diwou/Dottie_-_The_Matrix_Clock/kicad/source/NTP Dot Matrix Clock 64x16.kicad_pcb

## KiCad design kicad/source/NTP Dot Matrix Clock 64x16.kicad_pcb (2026-06-04)

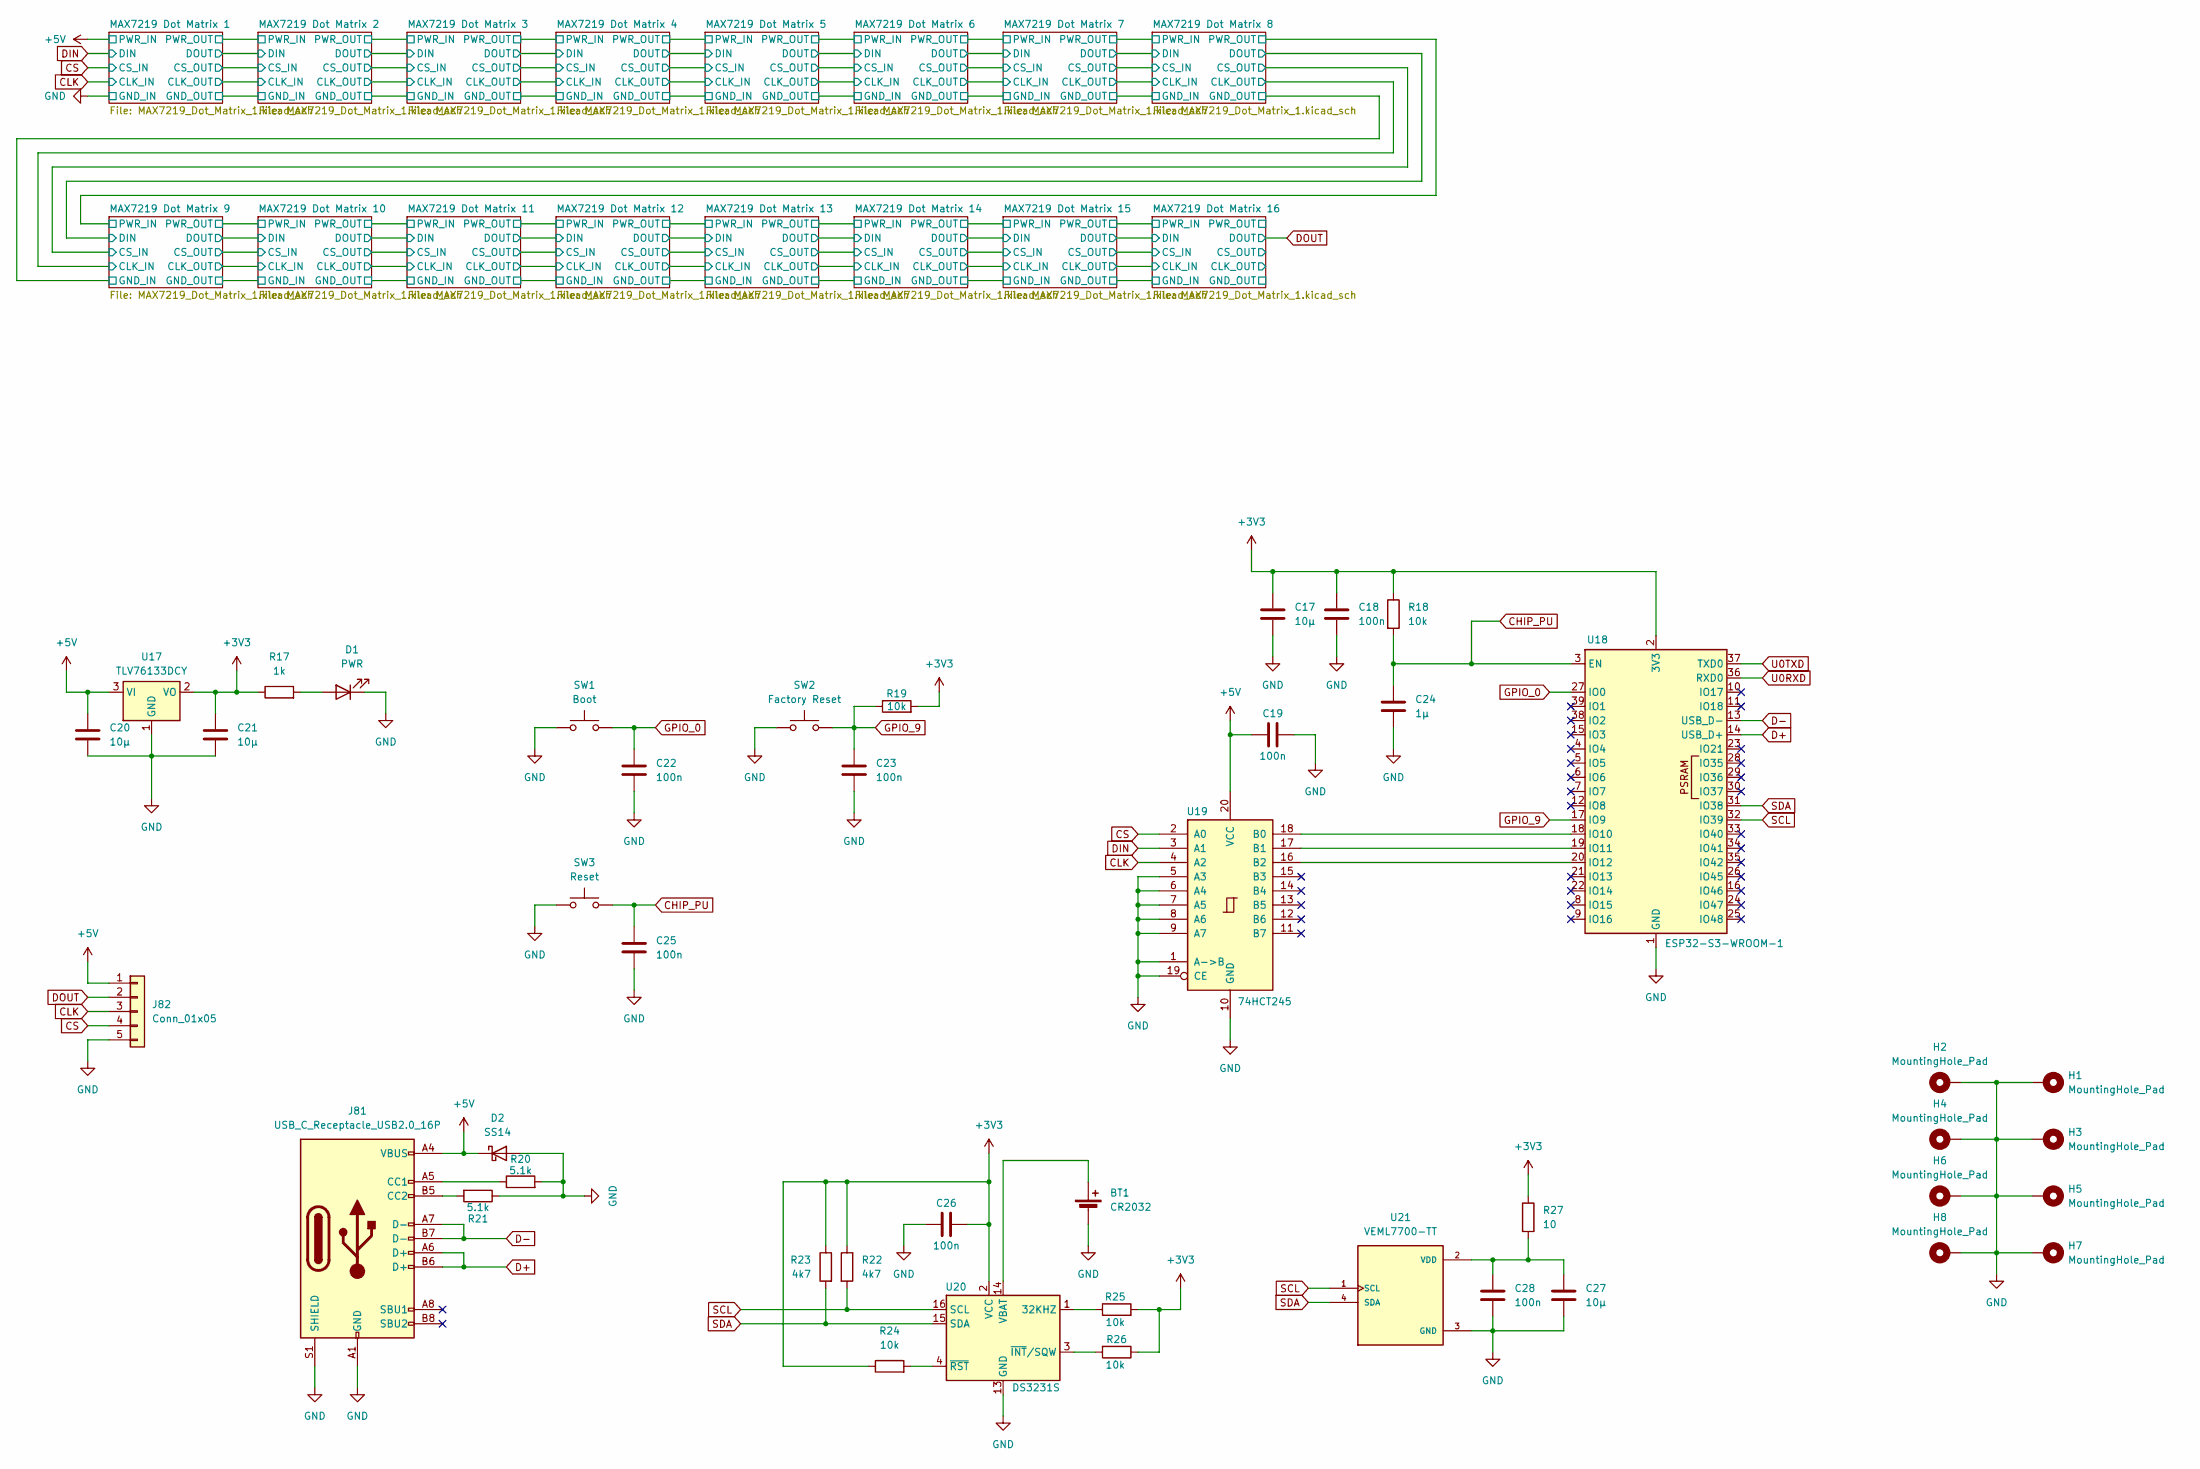
[picture p2: schematic NTP Dot Matrix Clock 64x16.kicad_sch]

Parts:
BT1: CR2032; BatteryHolder_MYOUNG_BS-07-A1BJ001_CR2032
C17, C27: 10µ; C_0805_2012Metric_Pad1.18x1.45mm_HandSolder
C18, C19, C22, C23, C25, C26, C28: 100n; C_0805_2012Metric_Pad1.18x1.45mm_HandSolder
C20, C21: 10µ; C_1206_3216Metric_Pad1.33x1.80mm_HandSolder
C24: 1µ; C_0805_2012Metric_Pad1.18x1.45mm_HandSolder
D1: PWR; LED_0805_2012Metric_Pad1.15x1.40mm_HandSolder
D2: SS14; D_SMA
H1, H2, H3, H4, H5, H6, H7, H8: MountingHole_Pad; MountingHole_3.2mm_M3_DIN965_Pad
J81: USB_C_Receptacle_USB2.0_16P; USB_C_Receptacle_HCTL_HC-TYPE-C-16P-01A
J82: Conn_01x05; PinHeader_1x05_P2.54mm_Vertical
R17: 1k; R_0805_2012Metric_Pad1.20x1.40mm_HandSolder
R18, R19, R24, R25, R26: 10k; R_0805_2012Metric_Pad1.20x1.40mm_HandSolder
R20, R21: 5.1k; R_0805_2012Metric_Pad1.20x1.40mm_HandSolder
R22, R23: 4k7; R_0805_2012Metric_Pad1.20x1.40mm_HandSolder
R27: 10; R_0805_2012Metric_Pad1.20x1.40mm_HandSolder
SW1: Boot; SW_PUSH_6mm_H5mm
SW2: Factory Reset; SW_PUSH_6mm_H5mm
SW3: Reset; SW_PUSH_6mm_H5mm
U17: TLV76133DCY; SOT-223-3_TabPin2
U18: ESP32-S3-WROOM-1
U19: 74HCT245; TSSOP-20_4.4x6.5mm_P0.65mm
U20: DS3231S; SOIC-16W_7.5x10.3mm_P1.27mm
U21: VEML7700-TT; XDCR_VEML7700-TT; PARTREV 1.6

Connections:
+3V3: C17.1, C18.1, C21.1, C26.2, R17.1, R18.1, R19.2, R22.1, R23.1, R24.1, R25.2, R26.1, R27.1, U17.2 (VO), U18.2 (3V3), U20.2 (VCC)
+5V: C19.1, C20.1, D2.1 (K), J81.A4 (VBUS), J81.A9 (VBUS), J81.B4 (VBUS), J81.B9 (VBUS), J82.1, U17.3 (VI), U19.20 (VCC); also elsewhere on the board
CHIP_PU: C24.1, C25.1, R18.2, SW3.2, U18.3 (EN)
CLK: J82.3, U19.4 (A2); also elsewhere on the board
CS: J82.4, U19.2 (A0); also elsewhere on the board
D+: J81.A6 (D+), J81.B6 (D+), U18.14 (USB_D+)
D-: J81.A7 (D-), J81.B7 (D-), U18.13 (USB_D-)
DIN: U19.3 (A1); also elsewhere on the board
DOUT: J82.2; also elsewhere on the board
GND: BT1.2 (-), C17.2, C18.2, C19.2, C20.2, C21.2, C22.2, C23.2, C24.2, C25.2, C26.1, C27.2, C28.2, D1.1 (K), D2.2 (A), H1.1 (1_1), H2.1 (1_1), H3.1 (1_1), H4.1 (1_1), H5.1 (1_1), H6.1 (1_1), H7.1 (1_1), H8.1 (1_1), J81.A1 (GND), J81.A12 (GND), J81.B1 (GND), J81.B12 (GND), J81.S1 (SHIELD), J82.5, R20.2, R21.1, SW1.1, SW2.1, SW3.1, U17.1 (GND), U18.1 (GND), U18.40 (GND), U18.41 (GND), U19.1 (A->B), U19.5 (A3), U19.6 (A4), U19.7 (A5), U19.8 (A6), U19.9 (A7), U19.10 (GND), U19.19 (CE), U20.5 (GND), U20.6 (GND), U20.7 (GND), U20.8 (GND), U20.9 (GND), U20.10 (GND), U20.11 (GND), U20.12 (GND), U20.13 (GND), U21.3 (GND); also elsewhere on the board
GPIO_0: C22.1, SW1.2, U18.27 (IO0)
GPIO_9: C23.1, R19.1, SW2.2, U18.17 (IO9)
unnamed: BT1.1 (+), U20.14 (VBAT)
unnamed: D1.2 (A), R17.2
unnamed: J81.A5 (CC1), R20.1
unnamed: J81.B5 (CC2), R21.2
unnamed: U18.18 (IO10), U19.18 (B0)
unnamed: U18.19 (IO11), U19.17 (B1)
unnamed: U18.20 (IO12), U19.16 (B2)
unnamed: R25.1, U20.1 (32KHZ)
unnamed: R26.2, U20.3 (~INT/SQW)
unnamed: R24.2, U20.4 (~RST)
unnamed: C27.1, C28.1, R27.2, U21.2 (VDD)
SCL: R22.2, U18.32 (IO39), U20.16 (SCL), U21.1 (SCL)
SDA: R23.2, U18.31 (IO38), U20.15 (SDA), U21.4 (SDA)
U0RXD: U18.36 (RXD0)
U0TXD: U18.37 (TXD0)

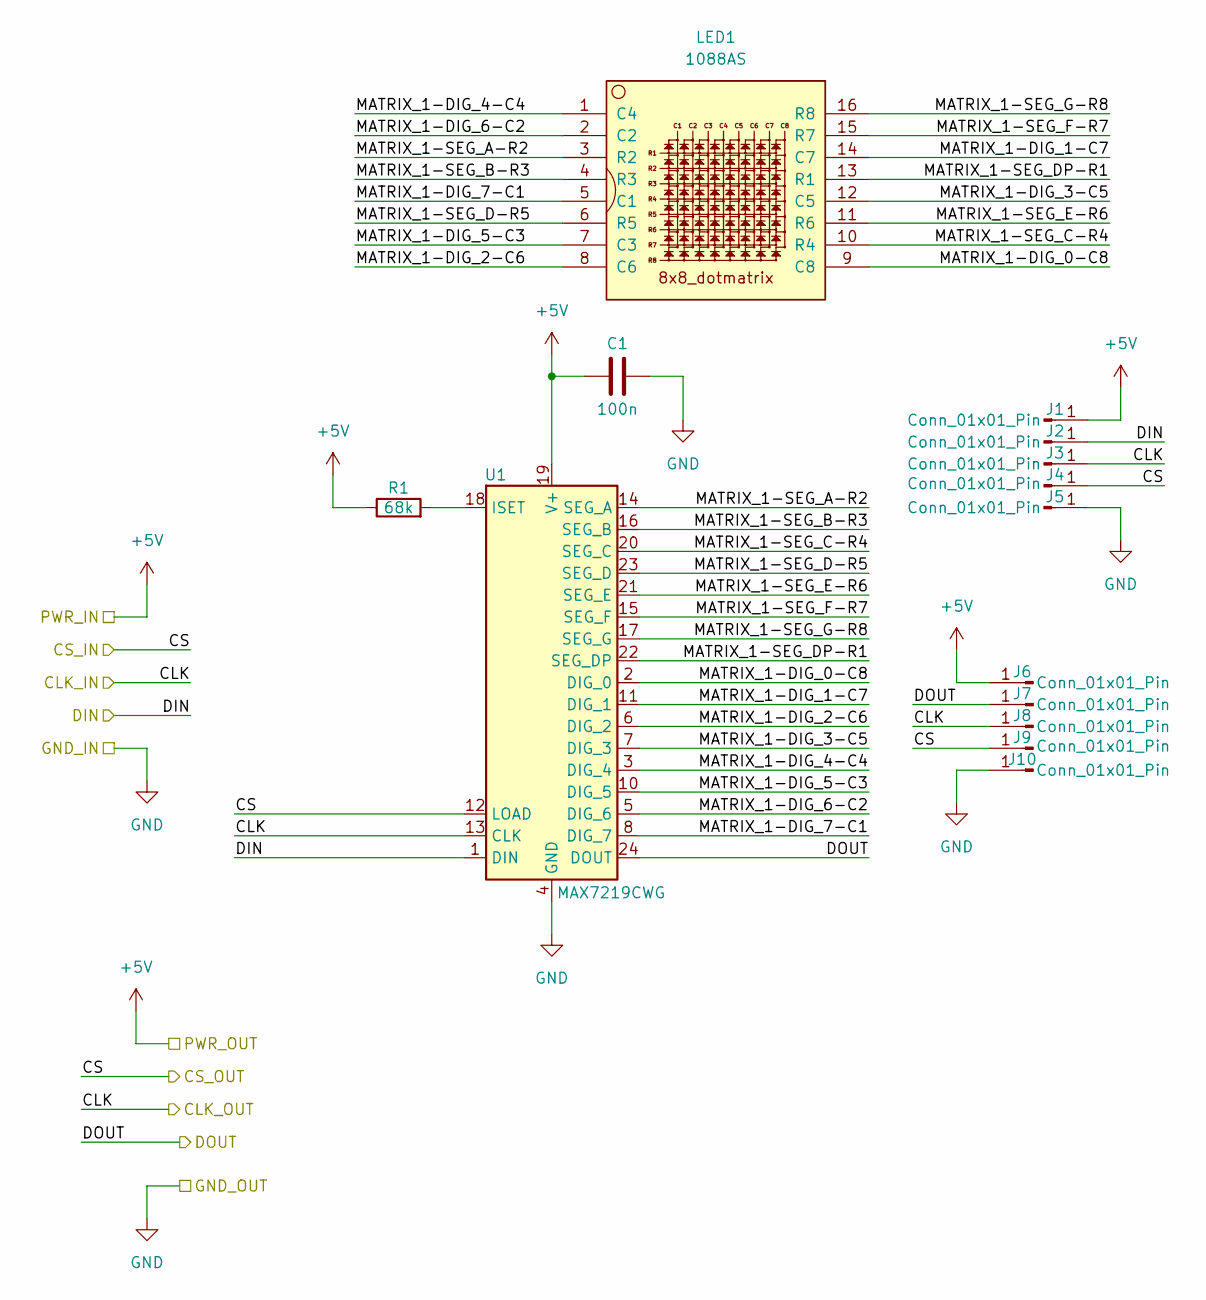
[picture p3: schematic MAX7219_Dot_Matrix_1.kicad_sch, NTP Dot Matrix Clock 64x16]

Parts:
C1: 100n; C_0805_2012Metric_Pad1.18x1.45mm_HandSolder
J1, J2, J3, J4, J5, J6, J7, J8, J9, J10: Conn_01x01_Pin; TestPoint_Pad_1.5x1.5mm
LED1: 1088AS; LED_1088_Pin_Header
R1: 68k; R_0805_2012Metric_Pad1.20x1.40mm_HandSolder
U1: MAX7219CWG; SOIC-24W_7.5x15.4mm_P1.27mm

Connections:
+5V: C1.1, J1.1 (Pin_1_1), J6.1 (Pin_1_1), R1.1, U1.19 (V+); also elsewhere on the board
/MAX7219 Dot Matrix 1/DOUT: J7.1 (Pin_1_1), U1.24 (DOUT); also elsewhere on the board
/MAX7219 Dot Matrix 1/MATRIX_1-DIG_0-C8: LED1.9 (C8), U1.2 (DIG_0)
/MAX7219 Dot Matrix 1/MATRIX_1-DIG_1-C7: LED1.14 (C7), U1.11 (DIG_1)
/MAX7219 Dot Matrix 1/MATRIX_1-DIG_2-C6: LED1.8 (C6), U1.6 (DIG_2)
/MAX7219 Dot Matrix 1/MATRIX_1-DIG_3-C5: LED1.12 (C5), U1.7 (DIG_3)
/MAX7219 Dot Matrix 1/MATRIX_1-DIG_4-C4: LED1.1 (C4), U1.3 (DIG_4)
/MAX7219 Dot Matrix 1/MATRIX_1-DIG_5-C3: LED1.7 (C3), U1.10 (DIG_5)
/MAX7219 Dot Matrix 1/MATRIX_1-DIG_6-C2: LED1.2 (C2), U1.5 (DIG_6)
/MAX7219 Dot Matrix 1/MATRIX_1-DIG_7-C1: LED1.5 (C1), U1.8 (DIG_7)
/MAX7219 Dot Matrix 1/MATRIX_1-SEG_A-R2: LED1.3 (R2), U1.14 (SEG_A)
/MAX7219 Dot Matrix 1/MATRIX_1-SEG_B-R3: LED1.4 (R3), U1.16 (SEG_B)
/MAX7219 Dot Matrix 1/MATRIX_1-SEG_C-R4: LED1.10 (R4), U1.20 (SEG_C)
/MAX7219 Dot Matrix 1/MATRIX_1-SEG_D-R5: LED1.6 (R5), U1.23 (SEG_D)
/MAX7219 Dot Matrix 1/MATRIX_1-SEG_DP-R1: LED1.13 (R1), U1.22 (SEG_DP)
/MAX7219 Dot Matrix 1/MATRIX_1-SEG_E-R6: LED1.11 (R6), U1.21 (SEG_E)
/MAX7219 Dot Matrix 1/MATRIX_1-SEG_F-R7: LED1.15 (R7), U1.15 (SEG_F)
/MAX7219 Dot Matrix 1/MATRIX_1-SEG_G-R8: LED1.16 (R8), U1.17 (SEG_G)
CLK: J3.1 (Pin_1_1), J8.1 (Pin_1_1), U1.13 (CLK); also elsewhere on the board
CS: J4.1 (Pin_1_1), J9.1 (Pin_1_1), U1.12 (LOAD); also elsewhere on the board
DIN: J2.1 (Pin_1_1), U1.1 (DIN); also elsewhere on the board
GND: C1.2, J5.1 (Pin_1_1), J10.1 (Pin_1_1), U1.4 (GND), U1.9 (GND); also elsewhere on the board
unnamed: R1.2, U1.18 (ISET)

Parts of its further copies:
C2, C3, C4, C5, C6, C7, C8, C9, C10, C11, C12, C13, C14, C15, C16: 100n; C_0805_2012Metric_Pad1.18x1.45mm_HandSolder
J11, J12, J13, J14, J15, J16, J17, J18, J19, J20, J21, J22, J23, J24, J25, J26, J27, J28, J29, J30, J31, J32, J33, J34, J35, J36, J37, J38, J39, J40, J41, J42, J43, J44, J45, J46, J47, J48, J49, J50, J51, J52, J53, J54, J55, J56, J57, J58, J59, J60, J61, J62, J63, J64, J65, J66, J67, J68, J69, J70, J71, J72, J73, J74, J75, J76, J77, J78, J79, J80, J83, J84, J85, J86, J87, J88, J89, J90, J91, J92, J93, J94, J95, J96, J97, J98, J99, J100, J101, J102, J103, J104, J105, J106, J107, J108, J109, J110, J111, J112, J113, J114, J115, J116, J117, J118, J119, J120, J121, J122, J123, J124, J125, J126, J127, J128, J129, J130, J131, J132, J133, J134, J135, J136, J137, J138, J139, J140, J141, J142, J143, J144, J145, J146, J147, J148, J149, J150, J151, J152, J153, J154, J155, J156, J157, J158, J159, J160, J161, J162: Conn_01x01_Pin; TestPoint_Pad_1.5x1.5mm
LED2, LED3, LED4, LED5, LED6, LED7, LED8, LED9, LED10, LED11, LED12, LED13, LED14, LED15, LED16: 1088AS; LED_1088_Pin_Header
R2, R3, R4, R5, R6, R7, R8, R9, R10, R11, R12, R13, R14, R15, R16: 68k; R_0805_2012Metric_Pad1.20x1.40mm_HandSolder
U2, U3, U4, U5, U6, U7, U8, U9, U10, U11, U12, U13, U14, U15, U16: MAX7219CWG; SOIC-24W_7.5x15.4mm_P1.27mm

Connections of its further copies:
+5V: C2.1, C3.1, C4.1, C5.1, C6.1, C7.1, C8.1, C9.1, C10.1, C11.1, C12.1, C13.1, C14.1, C15.1, C16.1, J11.1 (Pin_1_1), J16.1 (Pin_1_1), J21.1 (Pin_1_1), J26.1 (Pin_1_1), J31.1 (Pin_1_1), J36.1 (Pin_1_1), J41.1 (Pin_1_1), J46.1 (Pin_1_1), J51.1 (Pin_1_1), J56.1 (Pin_1_1), J61.1 (Pin_1_1), J66.1 (Pin_1_1), J71.1 (Pin_1_1), J76.1 (Pin_1_1), J83.1 (Pin_1_1), J88.1 (Pin_1_1), J93.1 (Pin_1_1), J98.1 (Pin_1_1), J103.1 (Pin_1_1), J108.1 (Pin_1_1), J113.1 (Pin_1_1), J118.1 (Pin_1_1), J123.1 (Pin_1_1), J128.1 (Pin_1_1), J133.1 (Pin_1_1), J138.1 (Pin_1_1), J143.1 (Pin_1_1), J148.1 (Pin_1_1), J153.1 (Pin_1_1), J158.1 (Pin_1_1), R2.1, R3.1, R4.1, R5.1, R6.1, R7.1, R8.1, R9.1, R10.1, R11.1, R12.1, R13.1, R14.1, R15.1, R16.1, U2.19 (V+), U3.19 (V+), U4.19 (V+), U5.19 (V+), U6.19 (V+), U7.19 (V+), U8.19 (V+), U9.19 (V+), U10.19 (V+), U11.19 (V+), U12.19 (V+), U13.19 (V+), U14.19 (V+), U15.19 (V+), U16.19 (V+); also elsewhere on the board
/MAX7219 Dot Matrix 1/DOUT: J12.1 (Pin_1_1), U2.1 (DIN); also elsewhere on the board
/MAX7219 Dot Matrix 2/DOUT: J17.1 (Pin_1_1), J22.1 (Pin_1_1), U2.24 (DOUT), U3.1 (DIN)
/MAX7219 Dot Matrix 2/MATRIX_1-DIG_0-C8: LED2.9 (C8), U2.2 (DIG_0)
/MAX7219 Dot Matrix 2/MATRIX_1-DIG_1-C7: LED2.14 (C7), U2.11 (DIG_1)
/MAX7219 Dot Matrix 2/MATRIX_1-DIG_2-C6: LED2.8 (C6), U2.6 (DIG_2)
/MAX7219 Dot Matrix 2/MATRIX_1-DIG_3-C5: LED2.12 (C5), U2.7 (DIG_3)
/MAX7219 Dot Matrix 2/MATRIX_1-DIG_4-C4: LED2.1 (C4), U2.3 (DIG_4)
/MAX7219 Dot Matrix 2/MATRIX_1-DIG_5-C3: LED2.7 (C3), U2.10 (DIG_5)
/MAX7219 Dot Matrix 2/MATRIX_1-DIG_6-C2: LED2.2 (C2), U2.5 (DIG_6)
/MAX7219 Dot Matrix 2/MATRIX_1-DIG_7-C1: LED2.5 (C1), U2.8 (DIG_7)
/MAX7219 Dot Matrix 2/MATRIX_1-SEG_A-R2: LED2.3 (R2), U2.14 (SEG_A)
/MAX7219 Dot Matrix 2/MATRIX_1-SEG_B-R3: LED2.4 (R3), U2.16 (SEG_B)
/MAX7219 Dot Matrix 2/MATRIX_1-SEG_C-R4: LED2.10 (R4), U2.20 (SEG_C)
/MAX7219 Dot Matrix 2/MATRIX_1-SEG_D-R5: LED2.6 (R5), U2.23 (SEG_D)
/MAX7219 Dot Matrix 2/MATRIX_1-SEG_DP-R1: LED2.13 (R1), U2.22 (SEG_DP)
/MAX7219 Dot Matrix 2/MATRIX_1-SEG_E-R6: LED2.11 (R6), U2.21 (SEG_E)
/MAX7219 Dot Matrix 2/MATRIX_1-SEG_F-R7: LED2.15 (R7), U2.15 (SEG_F)
/MAX7219 Dot Matrix 2/MATRIX_1-SEG_G-R8: LED2.16 (R8), U2.17 (SEG_G)
/MAX7219 Dot Matrix 3/DOUT: J27.1 (Pin_1_1), J32.1 (Pin_1_1), U3.24 (DOUT), U4.1 (DIN)
/MAX7219 Dot Matrix 3/MATRIX_1-DIG_0-C8: LED3.9 (C8), U3.2 (DIG_0)
/MAX7219 Dot Matrix 3/MATRIX_1-DIG_1-C7: LED3.14 (C7), U3.11 (DIG_1)
/MAX7219 Dot Matrix 3/MATRIX_1-DIG_2-C6: LED3.8 (C6), U3.6 (DIG_2)
/MAX7219 Dot Matrix 3/MATRIX_1-DIG_3-C5: LED3.12 (C5), U3.7 (DIG_3)
/MAX7219 Dot Matrix 3/MATRIX_1-DIG_4-C4: LED3.1 (C4), U3.3 (DIG_4)
/MAX7219 Dot Matrix 3/MATRIX_1-DIG_5-C3: LED3.7 (C3), U3.10 (DIG_5)
/MAX7219 Dot Matrix 3/MATRIX_1-DIG_6-C2: LED3.2 (C2), U3.5 (DIG_6)
/MAX7219 Dot Matrix 3/MATRIX_1-DIG_7-C1: LED3.5 (C1), U3.8 (DIG_7)
/MAX7219 Dot Matrix 3/MATRIX_1-SEG_A-R2: LED3.3 (R2), U3.14 (SEG_A)
/MAX7219 Dot Matrix 3/MATRIX_1-SEG_B-R3: LED3.4 (R3), U3.16 (SEG_B)
/MAX7219 Dot Matrix 3/MATRIX_1-SEG_C-R4: LED3.10 (R4), U3.20 (SEG_C)
/MAX7219 Dot Matrix 3/MATRIX_1-SEG_D-R5: LED3.6 (R5), U3.23 (SEG_D)
/MAX7219 Dot Matrix 3/MATRIX_1-SEG_DP-R1: LED3.13 (R1), U3.22 (SEG_DP)
/MAX7219 Dot Matrix 3/MATRIX_1-SEG_E-R6: LED3.11 (R6), U3.21 (SEG_E)
/MAX7219 Dot Matrix 3/MATRIX_1-SEG_F-R7: LED3.15 (R7), U3.15 (SEG_F)
/MAX7219 Dot Matrix 3/MATRIX_1-SEG_G-R8: LED3.16 (R8), U3.17 (SEG_G)
/MAX7219 Dot Matrix 4/DOUT: J37.1 (Pin_1_1), J42.1 (Pin_1_1), U4.24 (DOUT), U5.1 (DIN)
/MAX7219 Dot Matrix 4/MATRIX_1-DIG_0-C8: LED4.9 (C8), U4.2 (DIG_0)
/MAX7219 Dot Matrix 4/MATRIX_1-DIG_1-C7: LED4.14 (C7), U4.11 (DIG_1)
/MAX7219 Dot Matrix 4/MATRIX_1-DIG_2-C6: LED4.8 (C6), U4.6 (DIG_2)
/MAX7219 Dot Matrix 4/MATRIX_1-DIG_3-C5: LED4.12 (C5), U4.7 (DIG_3)
/MAX7219 Dot Matrix 4/MATRIX_1-DIG_4-C4: LED4.1 (C4), U4.3 (DIG_4)
/MAX7219 Dot Matrix 4/MATRIX_1-DIG_5-C3: LED4.7 (C3), U4.10 (DIG_5)
/MAX7219 Dot Matrix 4/MATRIX_1-DIG_6-C2: LED4.2 (C2), U4.5 (DIG_6)
/MAX7219 Dot Matrix 4/MATRIX_1-DIG_7-C1: LED4.5 (C1), U4.8 (DIG_7)
/MAX7219 Dot Matrix 4/MATRIX_1-SEG_A-R2: LED4.3 (R2), U4.14 (SEG_A)
/MAX7219 Dot Matrix 4/MATRIX_1-SEG_B-R3: LED4.4 (R3), U4.16 (SEG_B)
/MAX7219 Dot Matrix 4/MATRIX_1-SEG_C-R4: LED4.10 (R4), U4.20 (SEG_C)
/MAX7219 Dot Matrix 4/MATRIX_1-SEG_D-R5: LED4.6 (R5), U4.23 (SEG_D)
/MAX7219 Dot Matrix 4/MATRIX_1-SEG_DP-R1: LED4.13 (R1), U4.22 (SEG_DP)
/MAX7219 Dot Matrix 4/MATRIX_1-SEG_E-R6: LED4.11 (R6), U4.21 (SEG_E)
/MAX7219 Dot Matrix 4/MATRIX_1-SEG_F-R7: LED4.15 (R7), U4.15 (SEG_F)
/MAX7219 Dot Matrix 4/MATRIX_1-SEG_G-R8: LED4.16 (R8), U4.17 (SEG_G)
/MAX7219 Dot Matrix 5/DOUT: J47.1 (Pin_1_1), J52.1 (Pin_1_1), U5.24 (DOUT), U6.1 (DIN)
/MAX7219 Dot Matrix 5/MATRIX_1-DIG_0-C8: LED5.9 (C8), U5.2 (DIG_0)
/MAX7219 Dot Matrix 5/MATRIX_1-DIG_1-C7: LED5.14 (C7), U5.11 (DIG_1)
/MAX7219 Dot Matrix 5/MATRIX_1-DIG_2-C6: LED5.8 (C6), U5.6 (DIG_2)
/MAX7219 Dot Matrix 5/MATRIX_1-DIG_3-C5: LED5.12 (C5), U5.7 (DIG_3)
/MAX7219 Dot Matrix 5/MATRIX_1-DIG_4-C4: LED5.1 (C4), U5.3 (DIG_4)
/MAX7219 Dot Matrix 5/MATRIX_1-DIG_5-C3: LED5.7 (C3), U5.10 (DIG_5)
/MAX7219 Dot Matrix 5/MATRIX_1-DIG_6-C2: LED5.2 (C2), U5.5 (DIG_6)
/MAX7219 Dot Matrix 5/MATRIX_1-DIG_7-C1: LED5.5 (C1), U5.8 (DIG_7)
/MAX7219 Dot Matrix 5/MATRIX_1-SEG_A-R2: LED5.3 (R2), U5.14 (SEG_A)
/MAX7219 Dot Matrix 5/MATRIX_1-SEG_B-R3: LED5.4 (R3), U5.16 (SEG_B)
/MAX7219 Dot Matrix 5/MATRIX_1-SEG_C-R4: LED5.10 (R4), U5.20 (SEG_C)
/MAX7219 Dot Matrix 5/MATRIX_1-SEG_D-R5: LED5.6 (R5), U5.23 (SEG_D)
/MAX7219 Dot Matrix 5/MATRIX_1-SEG_DP-R1: LED5.13 (R1), U5.22 (SEG_DP)
/MAX7219 Dot Matrix 5/MATRIX_1-SEG_E-R6: LED5.11 (R6), U5.21 (SEG_E)
/MAX7219 Dot Matrix 5/MATRIX_1-SEG_F-R7: LED5.15 (R7), U5.15 (SEG_F)
/MAX7219 Dot Matrix 5/MATRIX_1-SEG_G-R8: LED5.16 (R8), U5.17 (SEG_G)
/MAX7219 Dot Matrix 6/DOUT: J57.1 (Pin_1_1), J62.1 (Pin_1_1), U6.24 (DOUT), U7.1 (DIN)
/MAX7219 Dot Matrix 6/MATRIX_1-DIG_0-C8: LED6.9 (C8), U6.2 (DIG_0)
/MAX7219 Dot Matrix 6/MATRIX_1-DIG_1-C7: LED6.14 (C7), U6.11 (DIG_1)
/MAX7219 Dot Matrix 6/MATRIX_1-DIG_2-C6: LED6.8 (C6), U6.6 (DIG_2)
/MAX7219 Dot Matrix 6/MATRIX_1-DIG_3-C5: LED6.12 (C5), U6.7 (DIG_3)
/MAX7219 Dot Matrix 6/MATRIX_1-DIG_4-C4: LED6.1 (C4), U6.3 (DIG_4)
/MAX7219 Dot Matrix 6/MATRIX_1-DIG_5-C3: LED6.7 (C3), U6.10 (DIG_5)
/MAX7219 Dot Matrix 6/MATRIX_1-DIG_6-C2: LED6.2 (C2), U6.5 (DIG_6)
/MAX7219 Dot Matrix 6/MATRIX_1-DIG_7-C1: LED6.5 (C1), U6.8 (DIG_7)
/MAX7219 Dot Matrix 6/MATRIX_1-SEG_A-R2: LED6.3 (R2), U6.14 (SEG_A)
/MAX7219 Dot Matrix 6/MATRIX_1-SEG_B-R3: LED6.4 (R3), U6.16 (SEG_B)
/MAX7219 Dot Matrix 6/MATRIX_1-SEG_C-R4: LED6.10 (R4), U6.20 (SEG_C)
/MAX7219 Dot Matrix 6/MATRIX_1-SEG_D-R5: LED6.6 (R5), U6.23 (SEG_D)
/MAX7219 Dot Matrix 6/MATRIX_1-SEG_DP-R1: LED6.13 (R1), U6.22 (SEG_DP)
/MAX7219 Dot Matrix 6/MATRIX_1-SEG_E-R6: LED6.11 (R6), U6.21 (SEG_E)
/MAX7219 Dot Matrix 6/MATRIX_1-SEG_F-R7: LED6.15 (R7), U6.15 (SEG_F)
/MAX7219 Dot Matrix 6/MATRIX_1-SEG_G-R8: LED6.16 (R8), U6.17 (SEG_G)
/MAX7219 Dot Matrix 7/DOUT: J67.1 (Pin_1_1), J72.1 (Pin_1_1), U7.24 (DOUT), U8.1 (DIN)
/MAX7219 Dot Matrix 7/MATRIX_1-DIG_0-C8: LED7.9 (C8), U7.2 (DIG_0)
/MAX7219 Dot Matrix 7/MATRIX_1-DIG_1-C7: LED7.14 (C7), U7.11 (DIG_1)
/MAX7219 Dot Matrix 7/MATRIX_1-DIG_2-C6: LED7.8 (C6), U7.6 (DIG_2)
/MAX7219 Dot Matrix 7/MATRIX_1-DIG_3-C5: LED7.12 (C5), U7.7 (DIG_3)
/MAX7219 Dot Matrix 7/MATRIX_1-DIG_4-C4: LED7.1 (C4), U7.3 (DIG_4)
/MAX7219 Dot Matrix 7/MATRIX_1-DIG_5-C3: LED7.7 (C3), U7.10 (DIG_5)
/MAX7219 Dot Matrix 7/MATRIX_1-DIG_6-C2: LED7.2 (C2), U7.5 (DIG_6)
/MAX7219 Dot Matrix 7/MATRIX_1-DIG_7-C1: LED7.5 (C1), U7.8 (DIG_7)
/MAX7219 Dot Matrix 7/MATRIX_1-SEG_A-R2: LED7.3 (R2), U7.14 (SEG_A)
/MAX7219 Dot Matrix 7/MATRIX_1-SEG_B-R3: LED7.4 (R3), U7.16 (SEG_B)
/MAX7219 Dot Matrix 7/MATRIX_1-SEG_C-R4: LED7.10 (R4), U7.20 (SEG_C)
/MAX7219 Dot Matrix 7/MATRIX_1-SEG_D-R5: LED7.6 (R5), U7.23 (SEG_D)
/MAX7219 Dot Matrix 7/MATRIX_1-SEG_DP-R1: LED7.13 (R1), U7.22 (SEG_DP)
/MAX7219 Dot Matrix 7/MATRIX_1-SEG_E-R6: LED7.11 (R6), U7.21 (SEG_E)
/MAX7219 Dot Matrix 7/MATRIX_1-SEG_F-R7: LED7.15 (R7), U7.15 (SEG_F)
/MAX7219 Dot Matrix 7/MATRIX_1-SEG_G-R8: LED7.16 (R8), U7.17 (SEG_G)
/MAX7219 Dot Matrix 8/DOUT: J77.1 (Pin_1_1), J84.1 (Pin_1_1), U8.24 (DOUT), U9.1 (DIN)
/MAX7219 Dot Matrix 8/MATRIX_1-DIG_0-C8: LED8.9 (C8), U8.2 (DIG_0)
/MAX7219 Dot Matrix 8/MATRIX_1-DIG_1-C7: LED8.14 (C7), U8.11 (DIG_1)
/MAX7219 Dot Matrix 8/MATRIX_1-DIG_2-C6: LED8.8 (C6), U8.6 (DIG_2)
/MAX7219 Dot Matrix 8/MATRIX_1-DIG_3-C5: LED8.12 (C5), U8.7 (DIG_3)
/MAX7219 Dot Matrix 8/MATRIX_1-DIG_4-C4: LED8.1 (C4), U8.3 (DIG_4)
/MAX7219 Dot Matrix 8/MATRIX_1-DIG_5-C3: LED8.7 (C3), U8.10 (DIG_5)
/MAX7219 Dot Matrix 8/MATRIX_1-DIG_6-C2: LED8.2 (C2), U8.5 (DIG_6)
/MAX7219 Dot Matrix 8/MATRIX_1-DIG_7-C1: LED8.5 (C1), U8.8 (DIG_7)
/MAX7219 Dot Matrix 8/MATRIX_1-SEG_A-R2: LED8.3 (R2), U8.14 (SEG_A)
/MAX7219 Dot Matrix 8/MATRIX_1-SEG_B-R3: LED8.4 (R3), U8.16 (SEG_B)
/MAX7219 Dot Matrix 8/MATRIX_1-SEG_C-R4: LED8.10 (R4), U8.20 (SEG_C)
/MAX7219 Dot Matrix 8/MATRIX_1-SEG_D-R5: LED8.6 (R5), U8.23 (SEG_D)
/MAX7219 Dot Matrix 8/MATRIX_1-SEG_DP-R1: LED8.13 (R1), U8.22 (SEG_DP)
/MAX7219 Dot Matrix 8/MATRIX_1-SEG_E-R6: LED8.11 (R6), U8.21 (SEG_E)
/MAX7219 Dot Matrix 8/MATRIX_1-SEG_F-R7: LED8.15 (R7), U8.15 (SEG_F)
/MAX7219 Dot Matrix 8/MATRIX_1-SEG_G-R8: LED8.16 (R8), U8.17 (SEG_G)
/MAX7219 Dot Matrix 9/MATRIX_1-DIG_0-C8: LED9.9 (C8), U9.2 (DIG_0)
/MAX7219 Dot Matrix 9/MATRIX_1-DIG_1-C7: LED9.14 (C7), U9.11 (DIG_1)
/MAX7219 Dot Matrix 9/MATRIX_1-DIG_2-C6: LED9.8 (C6), U9.6 (DIG_2)
/MAX7219 Dot Matrix 9/MATRIX_1-DIG_3-C5: LED9.12 (C5), U9.7 (DIG_3)
/MAX7219 Dot Matrix 9/MATRIX_1-DIG_4-C4: LED9.1 (C4), U9.3 (DIG_4)
/MAX7219 Dot Matrix 9/MATRIX_1-DIG_5-C3: LED9.7 (C3), U9.10 (DIG_5)
/MAX7219 Dot Matrix 9/MATRIX_1-DIG_6-C2: LED9.2 (C2), U9.5 (DIG_6)
/MAX7219 Dot Matrix 9/MATRIX_1-DIG_7-C1: LED9.5 (C1), U9.8 (DIG_7)
/MAX7219 Dot Matrix 9/MATRIX_1-SEG_A-R2: LED9.3 (R2), U9.14 (SEG_A)
/MAX7219 Dot Matrix 9/MATRIX_1-SEG_B-R3: LED9.4 (R3), U9.16 (SEG_B)
/MAX7219 Dot Matrix 9/MATRIX_1-SEG_C-R4: LED9.10 (R4), U9.20 (SEG_C)
/MAX7219 Dot Matrix 9/MATRIX_1-SEG_D-R5: LED9.6 (R5), U9.23 (SEG_D)
/MAX7219 Dot Matrix 9/MATRIX_1-SEG_DP-R1: LED9.13 (R1), U9.22 (SEG_DP)
/MAX7219 Dot Matrix 9/MATRIX_1-SEG_E-R6: LED9.11 (R6), U9.21 (SEG_E)
/MAX7219 Dot Matrix 9/MATRIX_1-SEG_F-R7: LED9.15 (R7), U9.15 (SEG_F)
/MAX7219 Dot Matrix 9/MATRIX_1-SEG_G-R8: LED9.16 (R8), U9.17 (SEG_G)
/MAX7219 Dot Matrix 10/DIN: J89.1 (Pin_1_1), J94.1 (Pin_1_1), U9.24 (DOUT), U10.1 (DIN)
/MAX7219 Dot Matrix 10/DOUT: J99.1 (Pin_1_1), J104.1 (Pin_1_1), U10.24 (DOUT), U11.1 (DIN)
/MAX7219 Dot Matrix 10/MATRIX_1-DIG_0-C8: LED10.9 (C8), U10.2 (DIG_0)
/MAX7219 Dot Matrix 10/MATRIX_1-DIG_1-C7: LED10.14 (C7), U10.11 (DIG_1)
/MAX7219 Dot Matrix 10/MATRIX_1-DIG_2-C6: LED10.8 (C6), U10.6 (DIG_2)
/MAX7219 Dot Matrix 10/MATRIX_1-DIG_3-C5: LED10.12 (C5), U10.7 (DIG_3)
/MAX7219 Dot Matrix 10/MATRIX_1-DIG_4-C4: LED10.1 (C4), U10.3 (DIG_4)
/MAX7219 Dot Matrix 10/MATRIX_1-DIG_5-C3: LED10.7 (C3), U10.10 (DIG_5)
/MAX7219 Dot Matrix 10/MATRIX_1-DIG_6-C2: LED10.2 (C2), U10.5 (DIG_6)
/MAX7219 Dot Matrix 10/MATRIX_1-DIG_7-C1: LED10.5 (C1), U10.8 (DIG_7)
/MAX7219 Dot Matrix 10/MATRIX_1-SEG_A-R2: LED10.3 (R2), U10.14 (SEG_A)
/MAX7219 Dot Matrix 10/MATRIX_1-SEG_B-R3: LED10.4 (R3), U10.16 (SEG_B)
/MAX7219 Dot Matrix 10/MATRIX_1-SEG_C-R4: LED10.10 (R4), U10.20 (SEG_C)
/MAX7219 Dot Matrix 10/MATRIX_1-SEG_D-R5: LED10.6 (R5), U10.23 (SEG_D)
/MAX7219 Dot Matrix 10/MATRIX_1-SEG_DP-R1: LED10.13 (R1), U10.22 (SEG_DP)
/MAX7219 Dot Matrix 10/MATRIX_1-SEG_E-R6: LED10.11 (R6), U10.21 (SEG_E)
/MAX7219 Dot Matrix 10/MATRIX_1-SEG_F-R7: LED10.15 (R7), U10.15 (SEG_F)
/MAX7219 Dot Matrix 10/MATRIX_1-SEG_G-R8: LED10.16 (R8), U10.17 (SEG_G)
/MAX7219 Dot Matrix 11/DOUT: J109.1 (Pin_1_1), J114.1 (Pin_1_1), U11.24 (DOUT), U12.1 (DIN)
/MAX7219 Dot Matrix 11/MATRIX_1-DIG_0-C8: LED11.9 (C8), U11.2 (DIG_0)
/MAX7219 Dot Matrix 11/MATRIX_1-DIG_1-C7: LED11.14 (C7), U11.11 (DIG_1)
/MAX7219 Dot Matrix 11/MATRIX_1-DIG_2-C6: LED11.8 (C6), U11.6 (DIG_2)
/MAX7219 Dot Matrix 11/MATRIX_1-DIG_3-C5: LED11.12 (C5), U11.7 (DIG_3)
/MAX7219 Dot Matrix 11/MATRIX_1-DIG_4-C4: LED11.1 (C4), U11.3 (DIG_4)
/MAX7219 Dot Matrix 11/MATRIX_1-DIG_5-C3: LED11.7 (C3), U11.10 (DIG_5)
/MAX7219 Dot Matrix 11/MATRIX_1-DIG_6-C2: LED11.2 (C2), U11.5 (DIG_6)
/MAX7219 Dot Matrix 11/MATRIX_1-DIG_7-C1: LED11.5 (C1), U11.8 (DIG_7)
/MAX7219 Dot Matrix 11/MATRIX_1-SEG_A-R2: LED11.3 (R2), U11.14 (SEG_A)
/MAX7219 Dot Matrix 11/MATRIX_1-SEG_B-R3: LED11.4 (R3), U11.16 (SEG_B)
/MAX7219 Dot Matrix 11/MATRIX_1-SEG_C-R4: LED11.10 (R4), U11.20 (SEG_C)
/MAX7219 Dot Matrix 11/MATRIX_1-SEG_D-R5: LED11.6 (R5), U11.23 (SEG_D)
/MAX7219 Dot Matrix 11/MATRIX_1-SEG_DP-R1: LED11.13 (R1), U11.22 (SEG_DP)
/MAX7219 Dot Matrix 11/MATRIX_1-SEG_E-R6: LED11.11 (R6), U11.21 (SEG_E)
/MAX7219 Dot Matrix 11/MATRIX_1-SEG_F-R7: LED11.15 (R7), U11.15 (SEG_F)
/MAX7219 Dot Matrix 11/MATRIX_1-SEG_G-R8: LED11.16 (R8), U11.17 (SEG_G)
/MAX7219 Dot Matrix 12/DOUT: J119.1 (Pin_1_1), J124.1 (Pin_1_1), U12.24 (DOUT), U13.1 (DIN)
/MAX7219 Dot Matrix 12/MATRIX_1-DIG_0-C8: LED12.9 (C8), U12.2 (DIG_0)
/MAX7219 Dot Matrix 12/MATRIX_1-DIG_1-C7: LED12.14 (C7), U12.11 (DIG_1)
/MAX7219 Dot Matrix 12/MATRIX_1-DIG_2-C6: LED12.8 (C6), U12.6 (DIG_2)
/MAX7219 Dot Matrix 12/MATRIX_1-DIG_3-C5: LED12.12 (C5), U12.7 (DIG_3)
/MAX7219 Dot Matrix 12/MATRIX_1-DIG_4-C4: LED12.1 (C4), U12.3 (DIG_4)
/MAX7219 Dot Matrix 12/MATRIX_1-DIG_5-C3: LED12.7 (C3), U12.10 (DIG_5)
/MAX7219 Dot Matrix 12/MATRIX_1-DIG_6-C2: LED12.2 (C2), U12.5 (DIG_6)
/MAX7219 Dot Matrix 12/MATRIX_1-DIG_7-C1: LED12.5 (C1), U12.8 (DIG_7)
/MAX7219 Dot Matrix 12/MATRIX_1-SEG_A-R2: LED12.3 (R2), U12.14 (SEG_A)
/MAX7219 Dot Matrix 12/MATRIX_1-SEG_B-R3: LED12.4 (R3), U12.16 (SEG_B)
/MAX7219 Dot Matrix 12/MATRIX_1-SEG_C-R4: LED12.10 (R4), U12.20 (SEG_C)
/MAX7219 Dot Matrix 12/MATRIX_1-SEG_D-R5: LED12.6 (R5), U12.23 (SEG_D)
/MAX7219 Dot Matrix 12/MATRIX_1-SEG_DP-R1: LED12.13 (R1), U12.22 (SEG_DP)
/MAX7219 Dot Matrix 12/MATRIX_1-SEG_E-R6: LED12.11 (R6), U12.21 (SEG_E)
/MAX7219 Dot Matrix 12/MATRIX_1-SEG_F-R7: LED12.15 (R7), U12.15 (SEG_F)
/MAX7219 Dot Matrix 12/MATRIX_1-SEG_G-R8: LED12.16 (R8), U12.17 (SEG_G)
/MAX7219 Dot Matrix 13/DOUT: J129.1 (Pin_1_1), J134.1 (Pin_1_1), U13.24 (DOUT), U14.1 (DIN)
/MAX7219 Dot Matrix 13/MATRIX_1-DIG_0-C8: LED13.9 (C8), U13.2 (DIG_0)
/MAX7219 Dot Matrix 13/MATRIX_1-DIG_1-C7: LED13.14 (C7), U13.11 (DIG_1)
/MAX7219 Dot Matrix 13/MATRIX_1-DIG_2-C6: LED13.8 (C6), U13.6 (DIG_2)
/MAX7219 Dot Matrix 13/MATRIX_1-DIG_3-C5: LED13.12 (C5), U13.7 (DIG_3)
/MAX7219 Dot Matrix 13/MATRIX_1-DIG_4-C4: LED13.1 (C4), U13.3 (DIG_4)
/MAX7219 Dot Matrix 13/MATRIX_1-DIG_5-C3: LED13.7 (C3), U13.10 (DIG_5)
/MAX7219 Dot Matrix 13/MATRIX_1-DIG_6-C2: LED13.2 (C2), U13.5 (DIG_6)
/MAX7219 Dot Matrix 13/MATRIX_1-DIG_7-C1: LED13.5 (C1), U13.8 (DIG_7)
/MAX7219 Dot Matrix 13/MATRIX_1-SEG_A-R2: LED13.3 (R2), U13.14 (SEG_A)
/MAX7219 Dot Matrix 13/MATRIX_1-SEG_B-R3: LED13.4 (R3), U13.16 (SEG_B)
/MAX7219 Dot Matrix 13/MATRIX_1-SEG_C-R4: LED13.10 (R4), U13.20 (SEG_C)
/MAX7219 Dot Matrix 13/MATRIX_1-SEG_D-R5: LED13.6 (R5), U13.23 (SEG_D)
/MAX7219 Dot Matrix 13/MATRIX_1-SEG_DP-R1: LED13.13 (R1), U13.22 (SEG_DP)
/MAX7219 Dot Matrix 13/MATRIX_1-SEG_E-R6: LED13.11 (R6), U13.21 (SEG_E)
/MAX7219 Dot Matrix 13/MATRIX_1-SEG_F-R7: LED13.15 (R7), U13.15 (SEG_F)
/MAX7219 Dot Matrix 13/MATRIX_1-SEG_G-R8: LED13.16 (R8), U13.17 (SEG_G)
/MAX7219 Dot Matrix 14/DOUT: J139.1 (Pin_1_1), J144.1 (Pin_1_1), U14.24 (DOUT), U15.1 (DIN)
/MAX7219 Dot Matrix 14/MATRIX_1-DIG_0-C8: LED14.9 (C8), U14.2 (DIG_0)
/MAX7219 Dot Matrix 14/MATRIX_1-DIG_1-C7: LED14.14 (C7), U14.11 (DIG_1)
/MAX7219 Dot Matrix 14/MATRIX_1-DIG_2-C6: LED14.8 (C6), U14.6 (DIG_2)
/MAX7219 Dot Matrix 14/MATRIX_1-DIG_3-C5: LED14.12 (C5), U14.7 (DIG_3)
/MAX7219 Dot Matrix 14/MATRIX_1-DIG_4-C4: LED14.1 (C4), U14.3 (DIG_4)
/MAX7219 Dot Matrix 14/MATRIX_1-DIG_5-C3: LED14.7 (C3), U14.10 (DIG_5)
/MAX7219 Dot Matrix 14/MATRIX_1-DIG_6-C2: LED14.2 (C2), U14.5 (DIG_6)
/MAX7219 Dot Matrix 14/MATRIX_1-DIG_7-C1: LED14.5 (C1), U14.8 (DIG_7)
/MAX7219 Dot Matrix 14/MATRIX_1-SEG_A-R2: LED14.3 (R2), U14.14 (SEG_A)
/MAX7219 Dot Matrix 14/MATRIX_1-SEG_B-R3: LED14.4 (R3), U14.16 (SEG_B)
/MAX7219 Dot Matrix 14/MATRIX_1-SEG_C-R4: LED14.10 (R4), U14.20 (SEG_C)
/MAX7219 Dot Matrix 14/MATRIX_1-SEG_D-R5: LED14.6 (R5), U14.23 (SEG_D)
/MAX7219 Dot Matrix 14/MATRIX_1-SEG_DP-R1: LED14.13 (R1), U14.22 (SEG_DP)
/MAX7219 Dot Matrix 14/MATRIX_1-SEG_E-R6: LED14.11 (R6), U14.21 (SEG_E)
/MAX7219 Dot Matrix 14/MATRIX_1-SEG_F-R7: LED14.15 (R7), U14.15 (SEG_F)
/MAX7219 Dot Matrix 14/MATRIX_1-SEG_G-R8: LED14.16 (R8), U14.17 (SEG_G)
/MAX7219 Dot Matrix 15/DOUT: J149.1 (Pin_1_1), J154.1 (Pin_1_1), U15.24 (DOUT), U16.1 (DIN)
/MAX7219 Dot Matrix 15/MATRIX_1-DIG_0-C8: LED15.9 (C8), U15.2 (DIG_0)
/MAX7219 Dot Matrix 15/MATRIX_1-DIG_1-C7: LED15.14 (C7), U15.11 (DIG_1)
/MAX7219 Dot Matrix 15/MATRIX_1-DIG_2-C6: LED15.8 (C6), U15.6 (DIG_2)
/MAX7219 Dot Matrix 15/MATRIX_1-DIG_3-C5: LED15.12 (C5), U15.7 (DIG_3)
/MAX7219 Dot Matrix 15/MATRIX_1-DIG_4-C4: LED15.1 (C4), U15.3 (DIG_4)
/MAX7219 Dot Matrix 15/MATRIX_1-DIG_5-C3: LED15.7 (C3), U15.10 (DIG_5)
/MAX7219 Dot Matrix 15/MATRIX_1-DIG_6-C2: LED15.2 (C2), U15.5 (DIG_6)
/MAX7219 Dot Matrix 15/MATRIX_1-DIG_7-C1: LED15.5 (C1), U15.8 (DIG_7)
/MAX7219 Dot Matrix 15/MATRIX_1-SEG_A-R2: LED15.3 (R2), U15.14 (SEG_A)
/MAX7219 Dot Matrix 15/MATRIX_1-SEG_B-R3: LED15.4 (R3), U15.16 (SEG_B)
/MAX7219 Dot Matrix 15/MATRIX_1-SEG_C-R4: LED15.10 (R4), U15.20 (SEG_C)
/MAX7219 Dot Matrix 15/MATRIX_1-SEG_D-R5: LED15.6 (R5), U15.23 (SEG_D)
/MAX7219 Dot Matrix 15/MATRIX_1-SEG_DP-R1: LED15.13 (R1), U15.22 (SEG_DP)
/MAX7219 Dot Matrix 15/MATRIX_1-SEG_E-R6: LED15.11 (R6), U15.21 (SEG_E)
/MAX7219 Dot Matrix 15/MATRIX_1-SEG_F-R7: LED15.15 (R7), U15.15 (SEG_F)
/MAX7219 Dot Matrix 15/MATRIX_1-SEG_G-R8: LED15.16 (R8), U15.17 (SEG_G)
/MAX7219 Dot Matrix 16/MATRIX_1-DIG_0-C8: LED16.9 (C8), U16.2 (DIG_0)
/MAX7219 Dot Matrix 16/MATRIX_1-DIG_1-C7: LED16.14 (C7), U16.11 (DIG_1)
/MAX7219 Dot Matrix 16/MATRIX_1-DIG_2-C6: LED16.8 (C6), U16.6 (DIG_2)
/MAX7219 Dot Matrix 16/MATRIX_1-DIG_3-C5: LED16.12 (C5), U16.7 (DIG_3)
/MAX7219 Dot Matrix 16/MATRIX_1-DIG_4-C4: LED16.1 (C4), U16.3 (DIG_4)
/MAX7219 Dot Matrix 16/MATRIX_1-DIG_5-C3: LED16.7 (C3), U16.10 (DIG_5)
/MAX7219 Dot Matrix 16/MATRIX_1-DIG_6-C2: LED16.2 (C2), U16.5 (DIG_6)
/MAX7219 Dot Matrix 16/MATRIX_1-DIG_7-C1: LED16.5 (C1), U16.8 (DIG_7)
/MAX7219 Dot Matrix 16/MATRIX_1-SEG_A-R2: LED16.3 (R2), U16.14 (SEG_A)
/MAX7219 Dot Matrix 16/MATRIX_1-SEG_B-R3: LED16.4 (R3), U16.16 (SEG_B)
/MAX7219 Dot Matrix 16/MATRIX_1-SEG_C-R4: LED16.10 (R4), U16.20 (SEG_C)
/MAX7219 Dot Matrix 16/MATRIX_1-SEG_D-R5: LED16.6 (R5), U16.23 (SEG_D)
/MAX7219 Dot Matrix 16/MATRIX_1-SEG_DP-R1: LED16.13 (R1), U16.22 (SEG_DP)
/MAX7219 Dot Matrix 16/MATRIX_1-SEG_E-R6: LED16.11 (R6), U16.21 (SEG_E)
/MAX7219 Dot Matrix 16/MATRIX_1-SEG_F-R7: LED16.15 (R7), U16.15 (SEG_F)
/MAX7219 Dot Matrix 16/MATRIX_1-SEG_G-R8: LED16.16 (R8), U16.17 (SEG_G)
CLK: J13.1 (Pin_1_1), J18.1 (Pin_1_1), J23.1 (Pin_1_1), J28.1 (Pin_1_1), J33.1 (Pin_1_1), J38.1 (Pin_1_1), J43.1 (Pin_1_1), J48.1 (Pin_1_1), J53.1 (Pin_1_1), J58.1 (Pin_1_1), J63.1 (Pin_1_1), J68.1 (Pin_1_1), J73.1 (Pin_1_1), J78.1 (Pin_1_1), J85.1 (Pin_1_1), J90.1 (Pin_1_1), J95.1 (Pin_1_1), J100.1 (Pin_1_1), J105.1 (Pin_1_1), J110.1 (Pin_1_1), J115.1 (Pin_1_1), J120.1 (Pin_1_1), J125.1 (Pin_1_1), J130.1 (Pin_1_1), J135.1 (Pin_1_1), J140.1 (Pin_1_1), J145.1 (Pin_1_1), J150.1 (Pin_1_1), J155.1 (Pin_1_1), J160.1 (Pin_1_1), U2.13 (CLK), U3.13 (CLK), U4.13 (CLK), U5.13 (CLK), U6.13 (CLK), U7.13 (CLK), U8.13 (CLK), U9.13 (CLK), U10.13 (CLK), U11.13 (CLK), U12.13 (CLK), U13.13 (CLK), U14.13 (CLK), U15.13 (CLK), U16.13 (CLK); also elsewhere on the board
CS: J14.1 (Pin_1_1), J19.1 (Pin_1_1), J24.1 (Pin_1_1), J29.1 (Pin_1_1), J34.1 (Pin_1_1), J39.1 (Pin_1_1), J44.1 (Pin_1_1), J49.1 (Pin_1_1), J54.1 (Pin_1_1), J59.1 (Pin_1_1), J64.1 (Pin_1_1), J69.1 (Pin_1_1), J74.1 (Pin_1_1), J79.1 (Pin_1_1), J86.1 (Pin_1_1), J91.1 (Pin_1_1), J96.1 (Pin_1_1), J101.1 (Pin_1_1), J106.1 (Pin_1_1), J111.1 (Pin_1_1), J116.1 (Pin_1_1), J121.1 (Pin_1_1), J126.1 (Pin_1_1), J131.1 (Pin_1_1), J136.1 (Pin_1_1), J141.1 (Pin_1_1), J146.1 (Pin_1_1), J151.1 (Pin_1_1), J156.1 (Pin_1_1), J161.1 (Pin_1_1), U2.12 (LOAD), U3.12 (LOAD), U4.12 (LOAD), U5.12 (LOAD), U6.12 (LOAD), U7.12 (LOAD), U8.12 (LOAD), U9.12 (LOAD), U10.12 (LOAD), U11.12 (LOAD), U12.12 (LOAD), U13.12 (LOAD), U14.12 (LOAD), U15.12 (LOAD), U16.12 (LOAD); also elsewhere on the board
DOUT: J159.1 (Pin_1_1), U16.24 (DOUT); also elsewhere on the board
GND: C2.2, C3.2, C4.2, C5.2, C6.2, C7.2, C8.2, C9.2, C10.2, C11.2, C12.2, C13.2, C14.2, C15.2, C16.2, J15.1 (Pin_1_1), J20.1 (Pin_1_1), J25.1 (Pin_1_1), J30.1 (Pin_1_1), J35.1 (Pin_1_1), J40.1 (Pin_1_1), J45.1 (Pin_1_1), J50.1 (Pin_1_1), J55.1 (Pin_1_1), J60.1 (Pin_1_1), J65.1 (Pin_1_1), J70.1 (Pin_1_1), J75.1 (Pin_1_1), J80.1 (Pin_1_1), J87.1 (Pin_1_1), J92.1 (Pin_1_1), J97.1 (Pin_1_1), J102.1 (Pin_1_1), J107.1 (Pin_1_1), J112.1 (Pin_1_1), J117.1 (Pin_1_1), J122.1 (Pin_1_1), J127.1 (Pin_1_1), J132.1 (Pin_1_1), J137.1 (Pin_1_1), J142.1 (Pin_1_1), J147.1 (Pin_1_1), J152.1 (Pin_1_1), J157.1 (Pin_1_1), J162.1 (Pin_1_1), U2.4 (GND), U2.9 (GND), U3.4 (GND), U3.9 (GND), U4.4 (GND), U4.9 (GND), U5.4 (GND), U5.9 (GND), U6.4 (GND), U6.9 (GND), U7.4 (GND), U7.9 (GND), U8.4 (GND), U8.9 (GND), U9.4 (GND), U9.9 (GND), U10.4 (GND), U10.9 (GND), U11.4 (GND), U11.9 (GND), U12.4 (GND), U12.9 (GND), U13.4 (GND), U13.9 (GND), U14.4 (GND), U14.9 (GND), U15.4 (GND), U15.9 (GND), U16.4 (GND), U16.9 (GND); also elsewhere on the board
unnamed: R2.2, U2.18 (ISET)
unnamed: R3.2, U3.18 (ISET)
unnamed: R4.2, U4.18 (ISET)
unnamed: R5.2, U5.18 (ISET)
unnamed: R6.2, U6.18 (ISET)
unnamed: R7.2, U7.18 (ISET)
unnamed: R8.2, U8.18 (ISET)
unnamed: R9.2, U9.18 (ISET)
unnamed: R10.2, U10.18 (ISET)
unnamed: R11.2, U11.18 (ISET)
unnamed: R12.2, U12.18 (ISET)
unnamed: R13.2, U13.18 (ISET)
unnamed: R14.2, U14.18 (ISET)
unnamed: R15.2, U15.18 (ISET)
unnamed: R16.2, U16.18 (ISET)

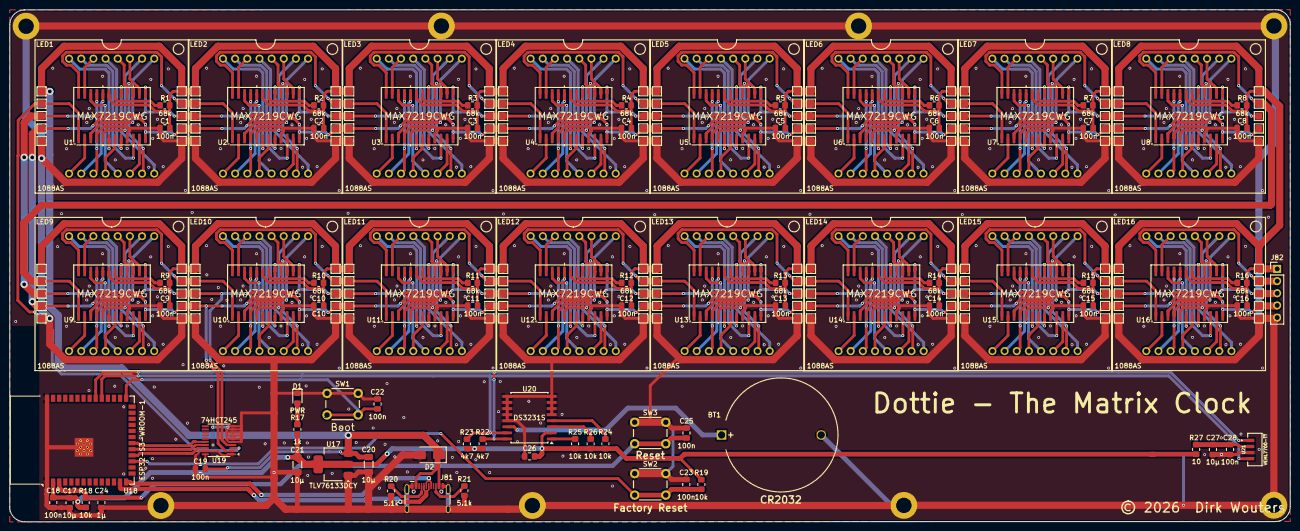
[picture p4: board NTP Dot Matrix Clock 64x16.kicad_pcb from above]

Board: 2 copper layers, 267.4 x 106.9 mm, 268 parts (0 on the bottom side), 312 nets.
