diwou/Dottie_-_The_Matrix_Clock/(commit log)

2026-04-28 fix: cspell und platformio stabilisieren
2026-04-29 refactor: NtpLogEntry von String auf char[]-Buffer umgestellt
    - NtpLogEntry.host und .detail sind jetzt char[NTP_LOG_HOST_LEN] bzw.
    char[NTP_LOG_DETAIL_LEN] statt String – vermeidet Heap-Fragmentierung
    im NTP-Log-Ringpuffer.
    - ntpLogAdd() verwendet strlcpy() statt direkter String-Zuweisung.
    - cspell.json: ntplog ergänzt.
    Ref: review-2026-04-29-ntplog-char
2026-05-10 feat: portiere Firmware auf ESP32-S3-Platine
2026-05-10 fix: setze Reset- und I2C-Pins auf Platinenbelegung
2026-05-10 fix: initialisiere LittleFS auf dem ESP32-S3
2026-05-10 fix: nutze eigenen SPI-Bus fuer das Display
    [main.cpp]
2026-05-10 fix: nutze HSPI fuer das Display
    [main.cpp]
2026-05-10 fix: nutze direkten GPIO-Modus fuer das Display
    [main.cpp]
2026-05-10 fix: drehe obere module und synchronisiere ntp sofort
    [display.h, main.cpp]
2026-05-10 fix: korrigiere reihenfolge der oberen module
    [display.h]
2026-05-10 fix: integriere VEML7700 autohelligkeit
    [main.cpp]
2026-05-10 fix: zeige i2c-diagnose fuer veml7700 an
    [main.cpp]
2026-05-10 fix: entkopple webserver und fuege ota-task hinzu
    [main.cpp]
2026-05-10 fix: wiederhole veml7700-init bei nack
    [main.cpp]
2026-05-10 fix: ota auch im ap-modus aktivieren
    [main.cpp]
2026-05-10 fix: i2c-diagnose um ds3231 erweitern
    [main.cpp]
2026-05-11 fix: pwm-dimmen loopbasiert machen
    [main.cpp]
2026-05-11 fix: ntp-bei-start schneller erneut versuchen
    [main.cpp]
2026-05-11 fix: ntp-retry an dns-status binden
    [main.cpp]
2026-05-11 feat: rtc-tab und manuelle zeiteinstellung ergänzen
2026-05-11 feat: rtc als laufzeitquelle und rtc-status ergänzen
2026-05-11 docs: readme um rtc- und sensordetails erweitern
2026-05-11 docs: cr2032-pufferung der rtc dokumentieren
2026-05-11 docs: kicad-projektspiegel ins repo uebernehmen
    [MAX7219_Dot_Matrix.kicad_sch, MAX7219_Dot_Matrix1.kicad_sch, MAX7219_Dot_Matrix_1.kicad_sch, MAX7219_Dot_Matrix_2.kicad_sch, NTP Dot Matrix Clock 64x16.kicad_pcb, NTP Dot Matrix Clock 64x16.kicad_sch, NTP Dot Matrix Clock 8x8.kicad_sch, bom.csv]
2026-05-11 feat: firmware-installer und release 1.5.0
2026-05-11 docs: projektbild und pages-link nachziehen
2026-05-11 docs: installer-badge in der README ergaenzen
2026-05-11 feat: dark mode fuer die Web-UI
2026-05-15 fix: Webserver-Header umbenannt wegen Namenskonflikt unter Windows
    src/webserver.h in src/ClockWebUi.h umbenannt, um Konflikte mit dem
    ESP32-Framework-Header <WebServer.h> auf case-insensitiven Dateisystemen
    zu vermeiden. Includes, README, cspell und Changelog nachgezogen.
    [ClockWebUi.h, main.cpp]
2026-05-15 fix: ntp-subsekunden-praezision und halbe round-trip-zeit auswerten
    Subsekunden-Anteil der NTP-Transmit-Timestamp und halbe Round-Trip-Zeit
    werden jetzt ausgewertet und auf die naechste ganze Sekunde gerundet,
    bevor die RTC gesetzt wird. Behebt den ~1-Sekunden-Nachlauf der Uhrzeit.
    [main.cpp]
2026-05-15 fix: scroll-effekt mit gettimeofday-kompensation repariert
    Die fehlerhafte gettimeofday()-basierte Subsekunden-Kompensation
    in drawTimeHHMMSS() entfernt. gettimeofday() lieferte auf dem ESP32
    uninitialisierte Werte, wodurch die Animation auf einen Frame
    verkuerzt wurde und der Scroll-Effekt unsichtbar blieb.
    [display.h, main.cpp]
2026-05-15 fix: ntp-subsekunden-genauigkeit durch sekundengrenz-sync verbessert
    Vor dem RTC-Schreiben wird jetzt gezielt auf die naechste volle
    Sekundengrenze gewartet, damit die RTC exakt zur Sekundenmitte
    loslaeuft. Eliminiert den variablen Subsekunden-Versatz zwischen
    mehreren unabhaengig synchronisierten Uhren.
    [main.cpp]
2026-05-15 fix: race-condition beim speichern entfernt - brightness-update aus web-task entfernt
    [ClockWebUi.h]
2026-05-15 fix: compiler-caching und race-condition behoben - cfg-werte werden nicht mehr gecached, scroll-state-reset ueber flag
    [ClockWebUi.h, main.cpp]
2026-06-04 fix: korrigierte Platine V0.5
    [MAX7219_Dot_Matrix_1.kicad_sch, NTP Dot Matrix Clock 64x16.kicad_pcb, NTP Dot Matrix Clock 64x16.kicad_sch, bom.csv, designators.csv, positions.csv]
