diwou/Dottie_-_The_Matrix_Clock/(notices)

Notices in the files:
kicad/source/NTP Dot Matrix Clock 64x16.kicad_pcb:
© 2026 Dirk Wouters
License: CC BY-NC-SA 4.0
